EricJ48/ENCE-4231/PhaseB/Notes/solderedboardon.jpg

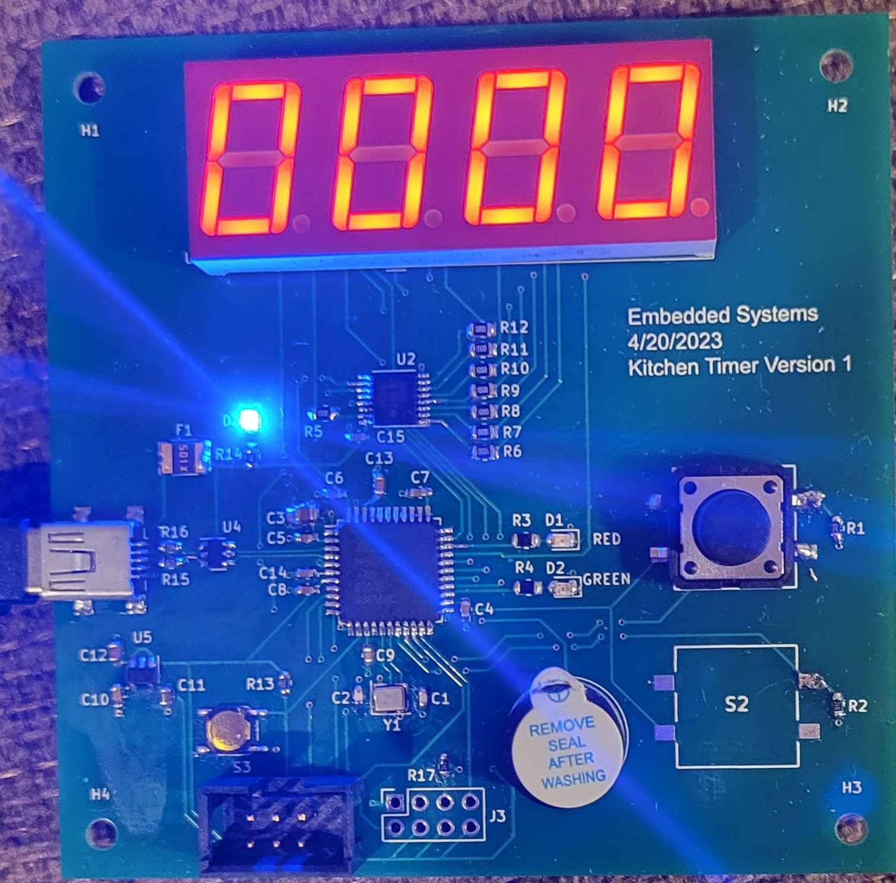
PhaseB/Notes/solderedboardon.jpg
