EricJ48/ENCE-4231/PhaseB/Notes/solderedboard.jpg

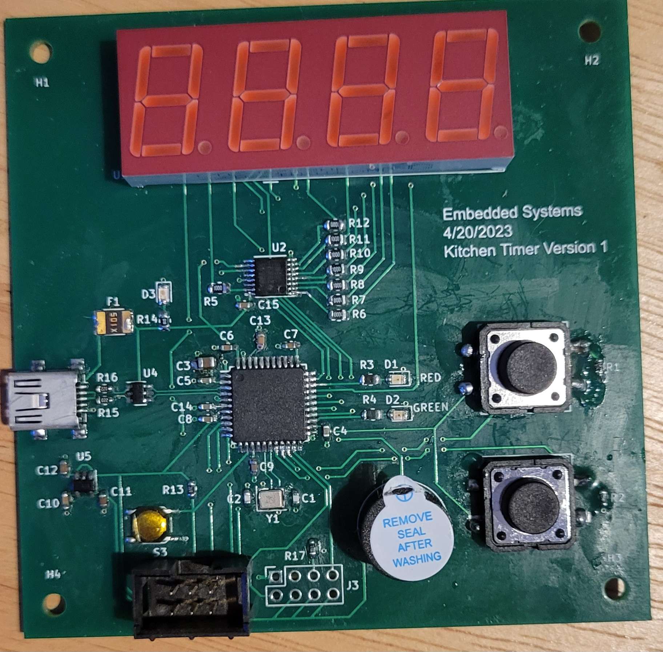
PhaseB/Notes/solderedboard.jpg
