EricJ48/ENCE-4231/PhaseAProofOfConcept.docx

Phase A – Proof of Concept

Kitchen Timer

Project requirements:

- Can be set to up to 100 minutes
- can increment/decrement by 1 second, 10 seconds, 30 seconds, 1 minute, 10 minutes, 30 minutes.
- Plays loud sound when timer runs out
- Needs a display

Components Selection:

- Pushbutton: https://www.amazon.com/6x6x6mm-Momentary-Push-Button-Switch/dp/B01GN79QF8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
- 7 segment display
- Buzzer
- LEDs
