EricJ48/ENCE-4231/PhaseB/Notes/SystemBlockDiagrams.pdf

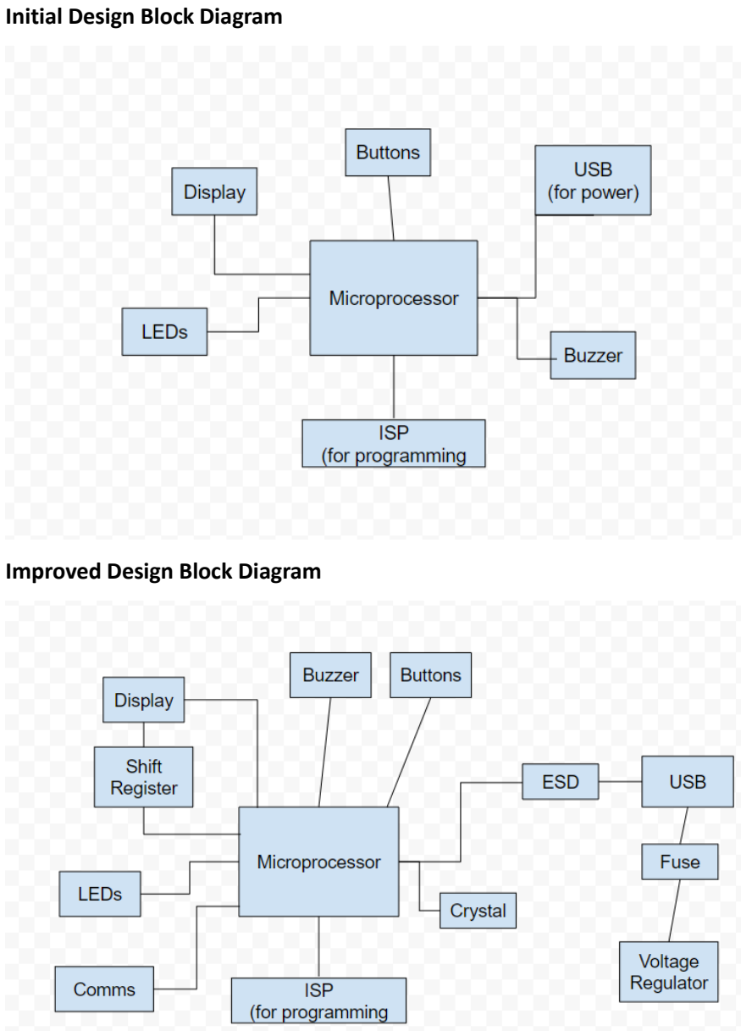
[picture p9: page 1]

Initial Design Block Diagram

Improved Design Block Diagram
