EricJ48/ENCE-4231/PhaseB/PCBDesign/Schematics/Schematic.png

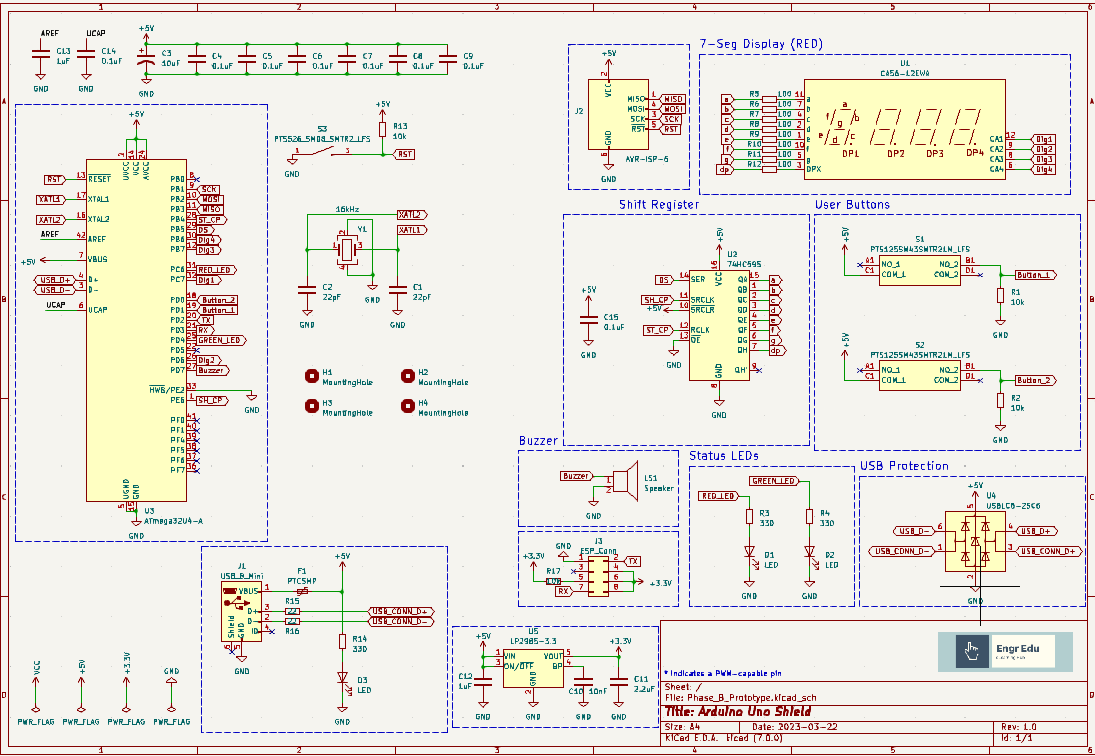
PhaseB/PCBDesign/Schematics/Schematic.png
