EricJ48/ENCE-4231/PhaseD_Nightlight/notes/blockdiagram.png

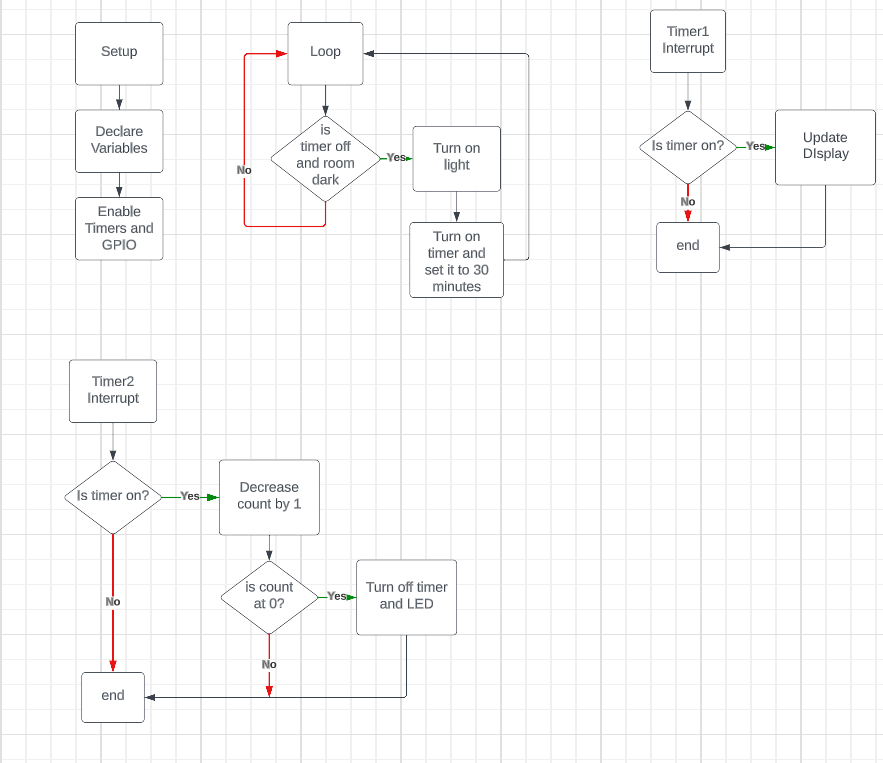
PhaseD_Nightlight/notes/blockdiagram.png
