EricJ48/ENCE-4231/PhaseD_Nightlight/PCBDesign/plots/3D_Model_front.png

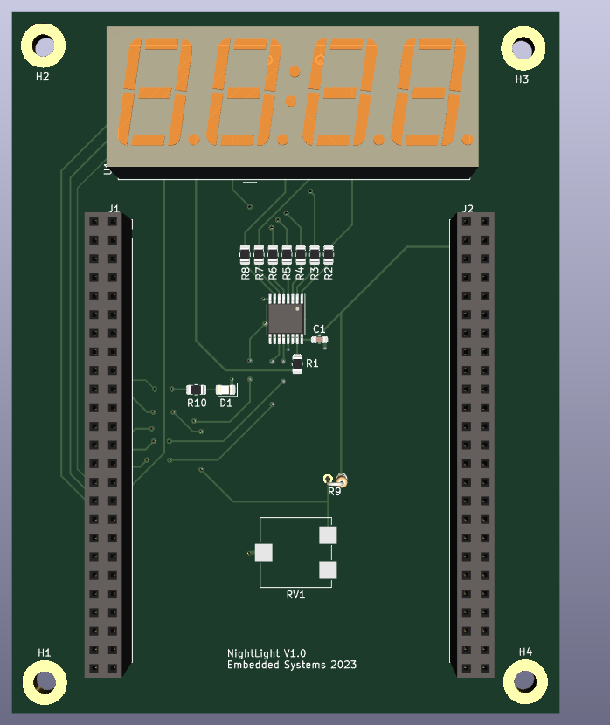
PhaseD_Nightlight/PCBDesign/plots/3D_Model_front.png
