EricJ48/ENCE-4231/PhaseD_Nightlight/PCBDesign/plots/PCB_Layout.png

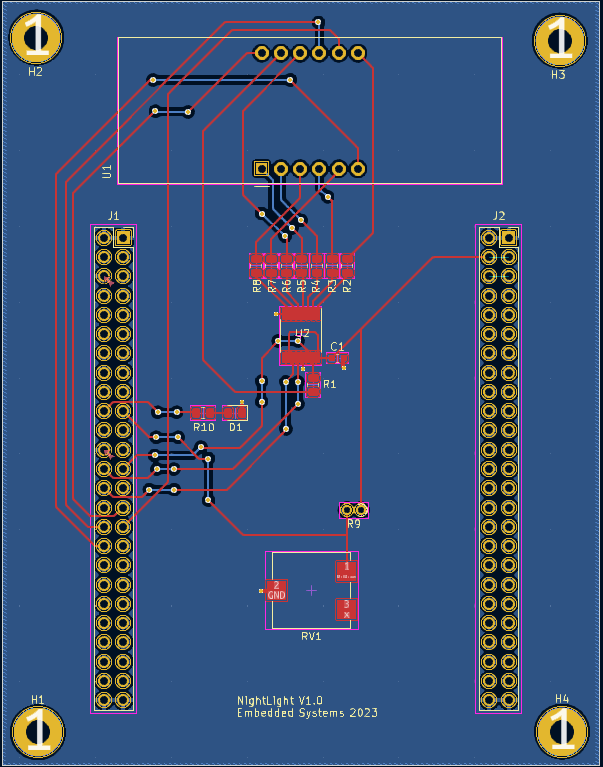
PhaseD_Nightlight/PCBDesign/plots/PCB_Layout.png
