EricJ48/ENCE-4231/PhaseD_Nightlight/PCBDesign/Schematics/Schematic.png

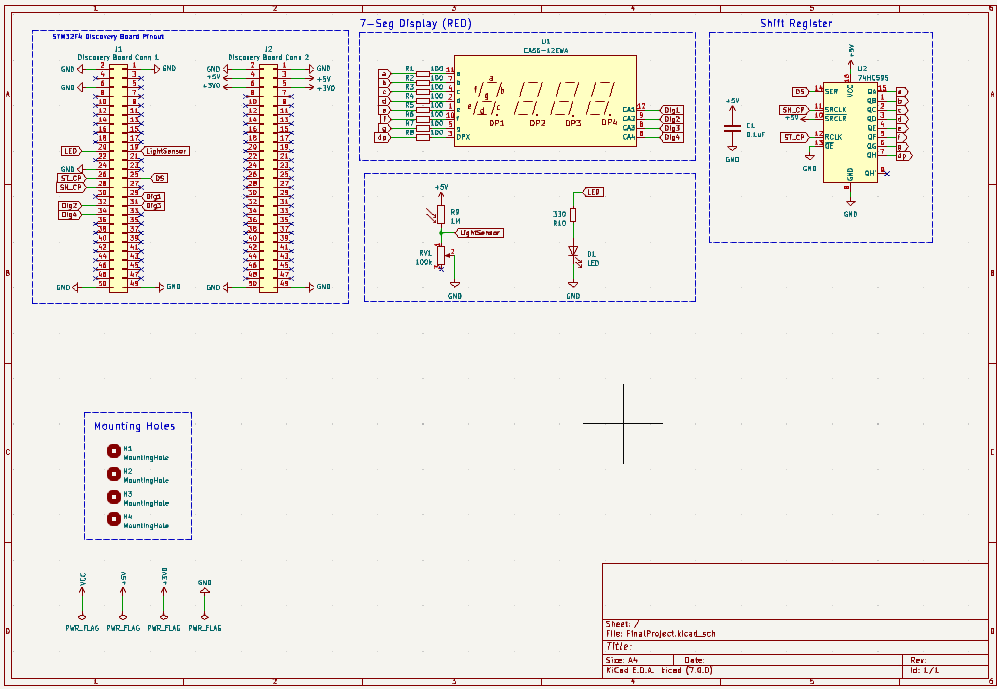
PhaseD_Nightlight/PCBDesign/Schematics/Schematic.png
