EricJ48/ENCE-4231/PhaseB/PCBDesign/Enclosure/TimerEnclosure.STEP

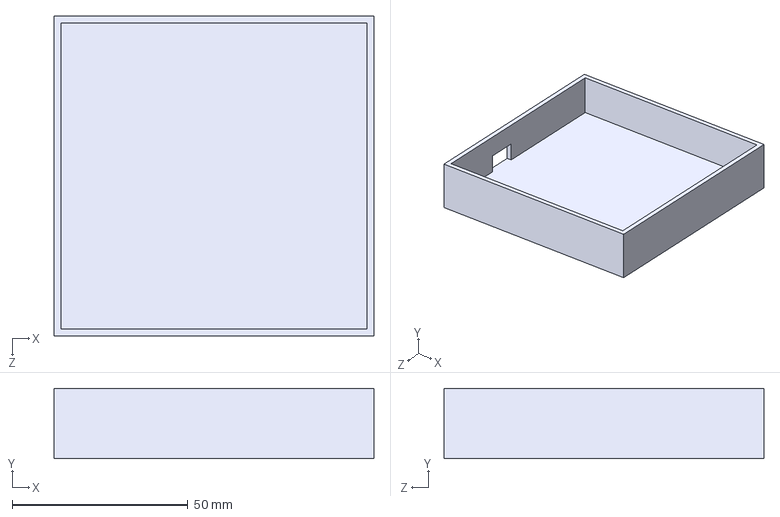
[picture p16: CAD file, 2023-05-04]
PhaseB/PCBDesign/Enclosure/TimerEnclosure.STEP
91.0 x 20.0 x 91.0 mm
