EricJ48/ENCE-4231/Phase_A_UnoShield/plots/PCB_Tutorial_UNOShield__Assembly.pdf

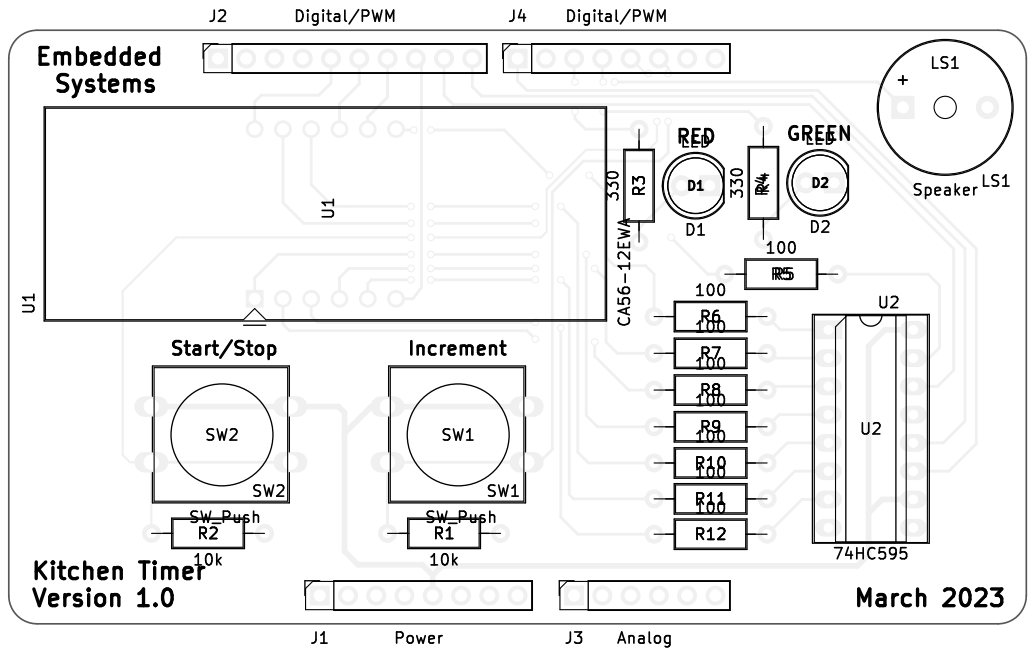
[picture p17: page 1]

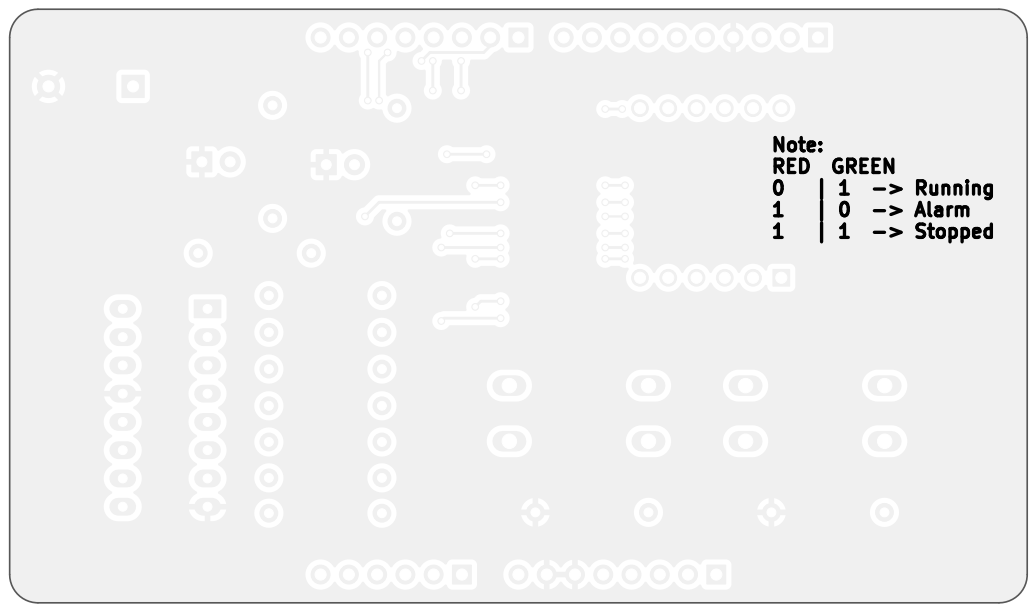
[picture p18: page 2]
D Date: 2023-03-22 KiCad; kicad; 7.0.1 Size: A4; Rev:; Id: 1/1 Title: File:; PCB_Tutorial_UNOShield.kicad_pcb Sheet:
