EricJ48/ENCE-4231/PhaseD_Nightlight/PCBDesign/plots/NightLight_Prototype_Assembly.pdf

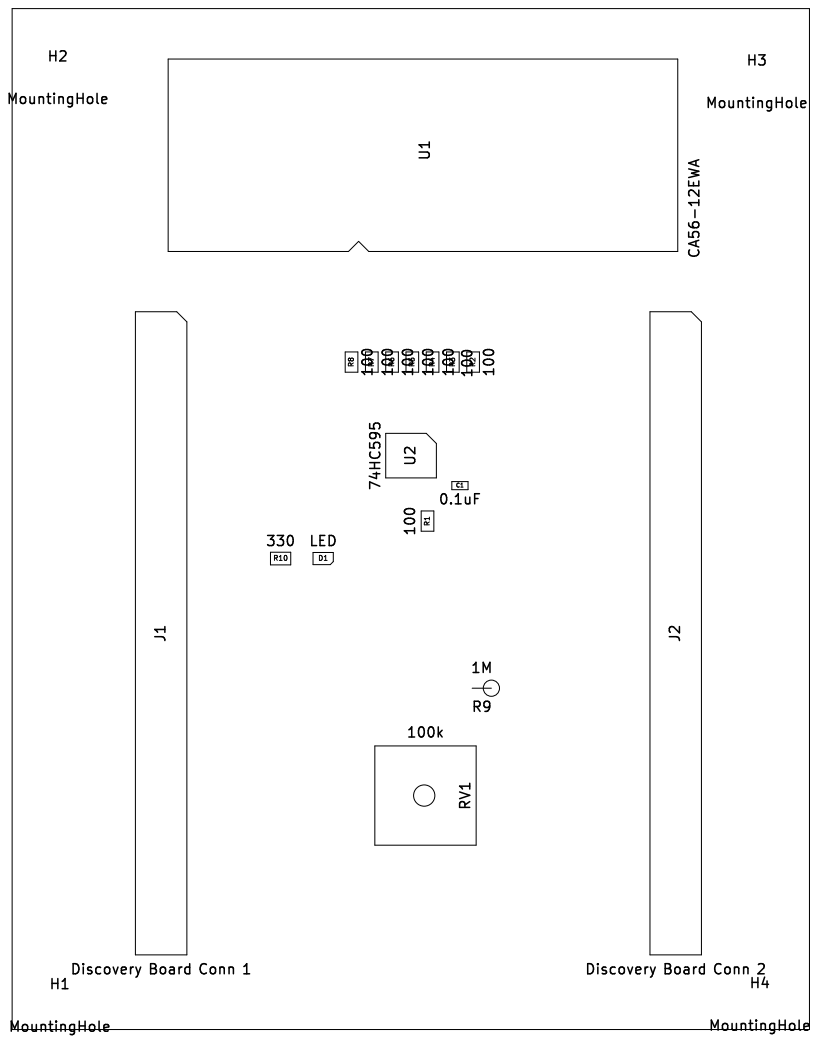
[picture p19: page 1]

Id: 1/1 Title: File: FinalProject.kicad_pcb Sheet:
