EricJ48/ENCE-4231/PhaseB/PCBDesign/Schematics/Phase_B_Prototype.pdf

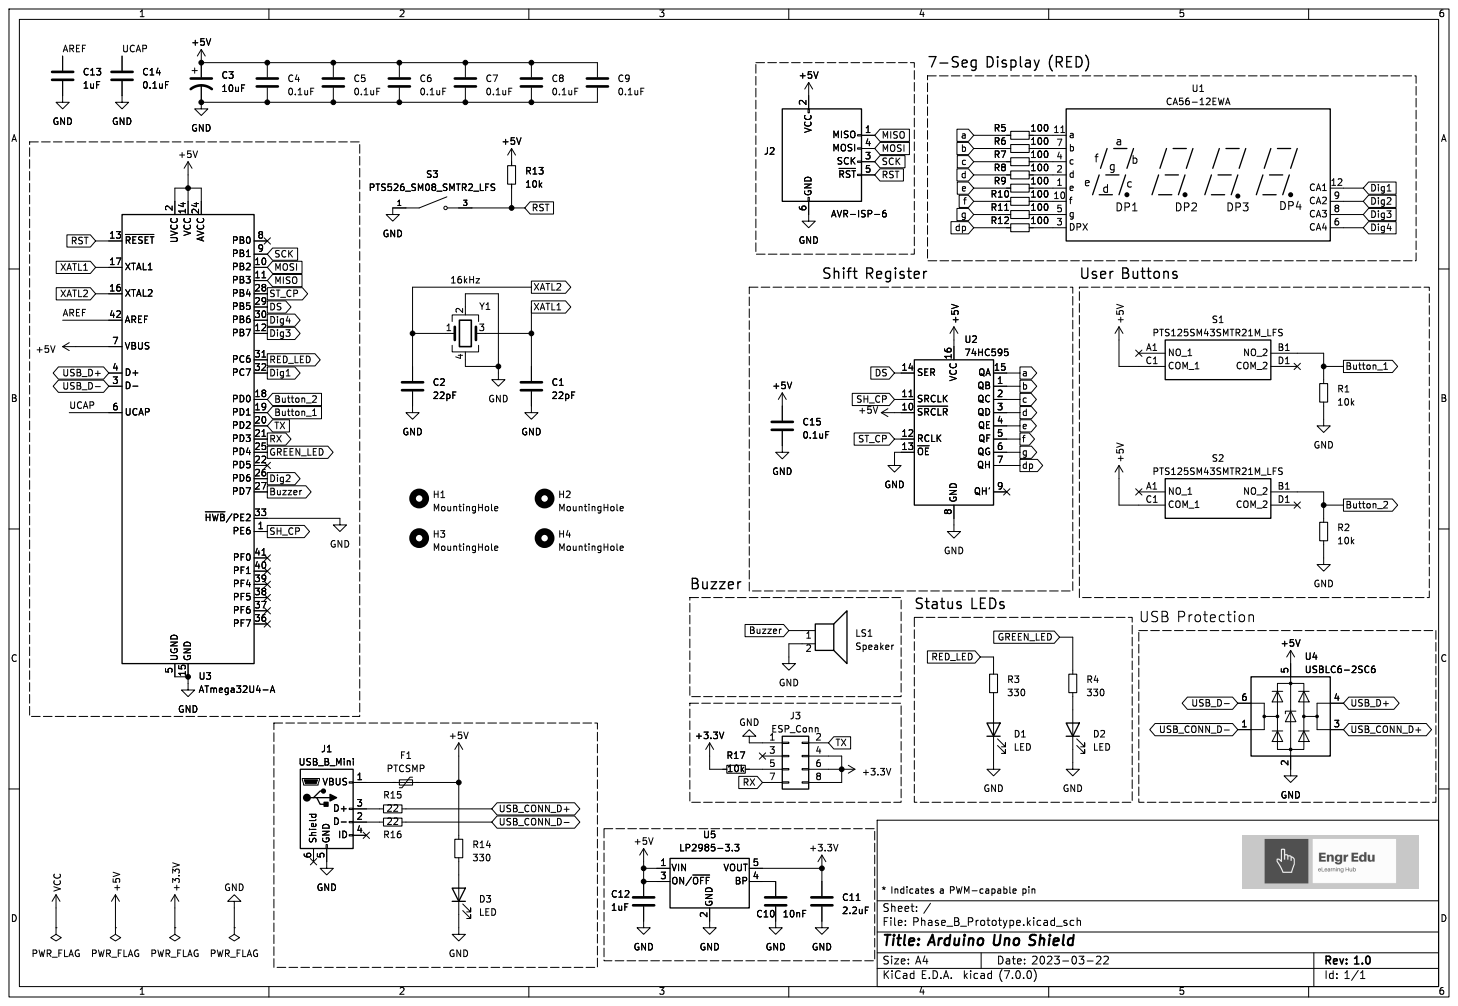
[picture p20: page 1]

2 SCK 3 MOSI 4 ~{RST}5 GND

2 ON/~{OFF} 3 BP 4 VOUT 5 U5

2 ON/~{OFF} 3 BP 4 VOUT 5 C12

File: Phase_B_Prototype.kicad_sch Sheet: /
Id: 1/1 Title: Arduino Uno Shield
