EricJ48/ENCE-4231/PhaseB/Notes/Code Block Diagram.pdf

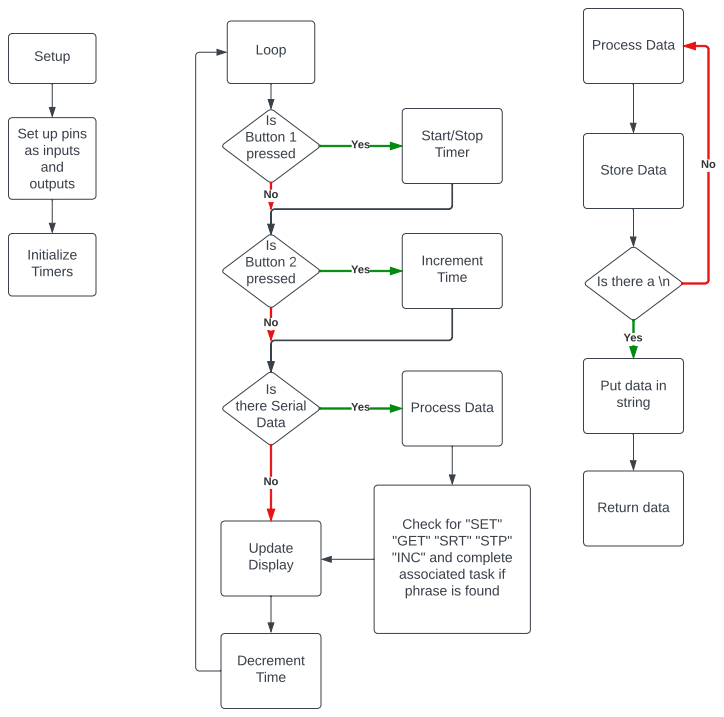
[picture p21: page 1]
Loop; Is Button 1 pressed; Yes; Start/Stop; Timer; Is Button 2 pressed; Increment Time; Is there Serial Data; Process Data; Store Data; Is there a \n; Update Display; Decrement Time; Setup; Initialize Timers; Return data

Set up pins
as inputs
and
outputs

Put data in
string

Check for "SET"
"GET" "SRT" "STP"
"INC" and complete
associated task if
phrase is found
