EricJ48/ENCE-4231/PhaseD_Nightlight/PCBDesign/Schematics/Schematic.pdf

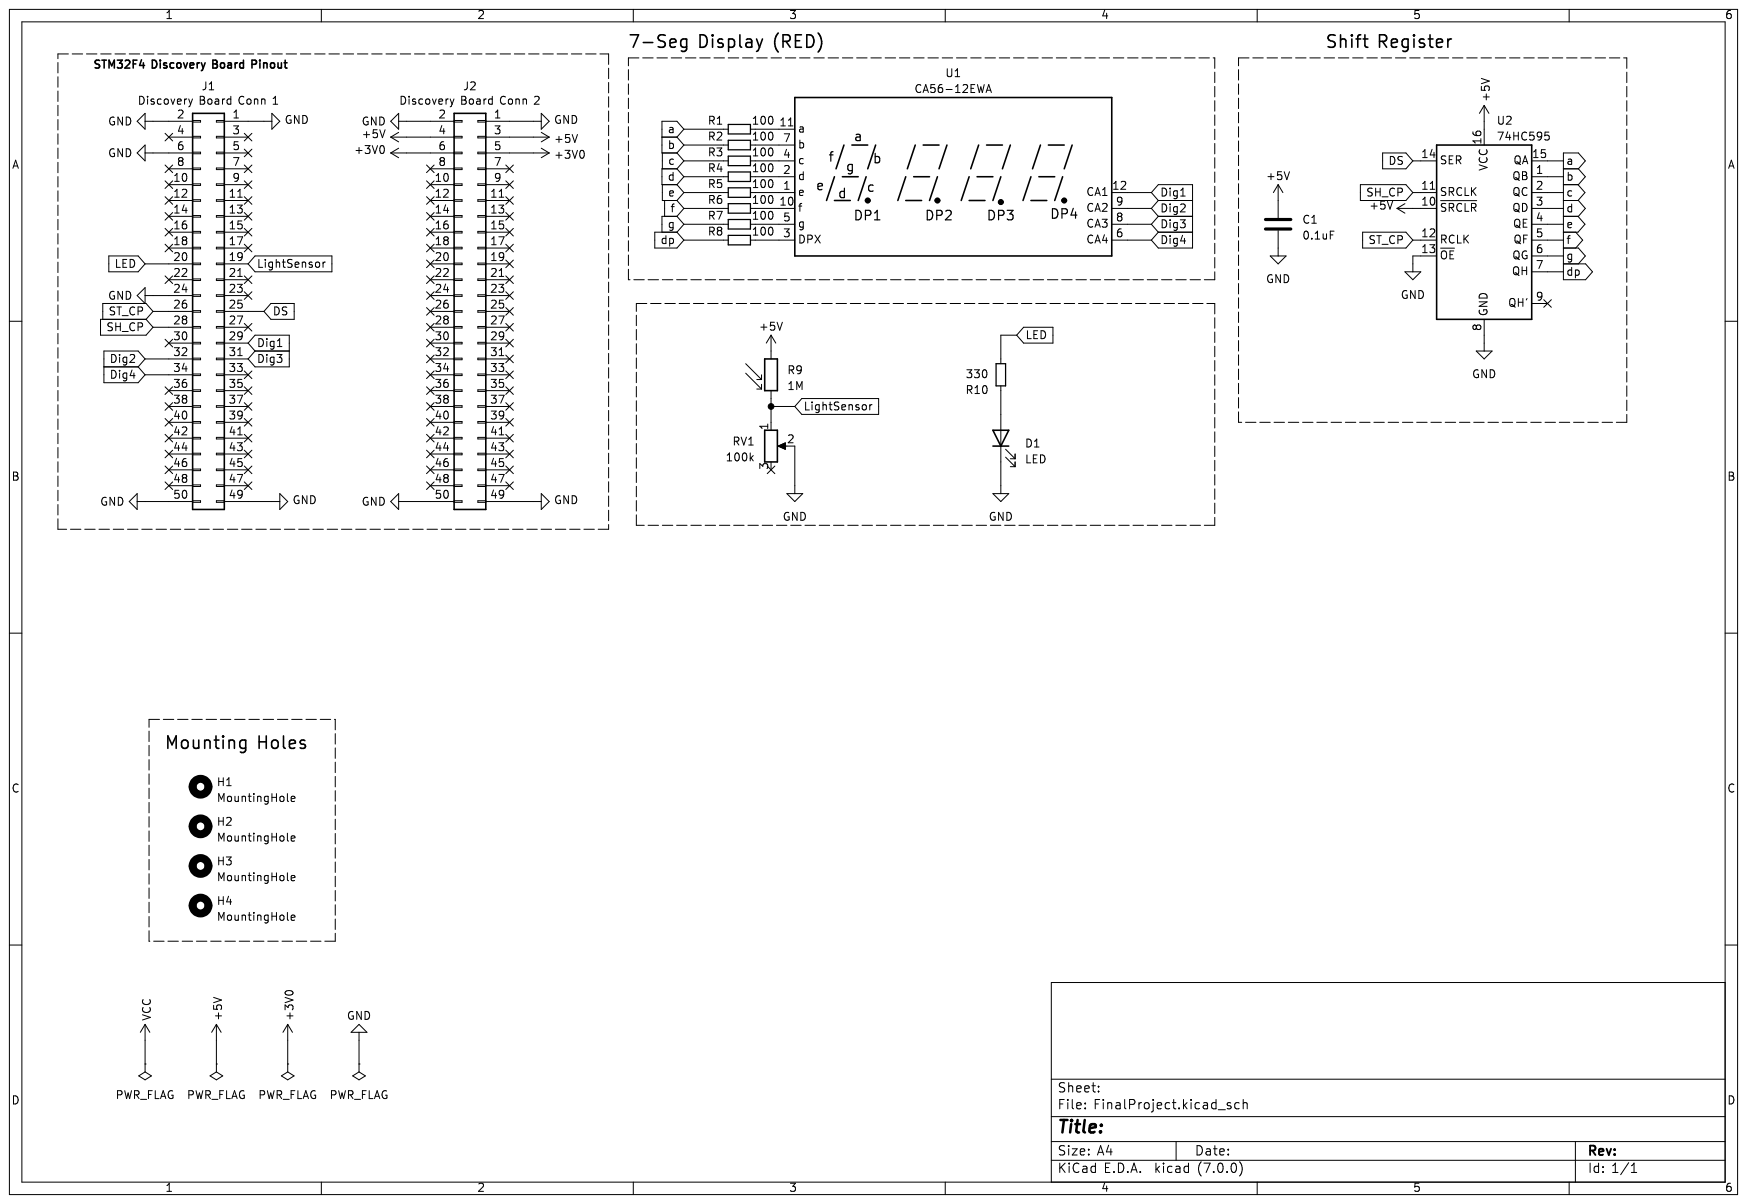
[picture p22: page 1]
