EricJ48/ENCE-4231/PhaseB/PCBDesign/plots/Phase_B_Prototype_Assembly.pdf

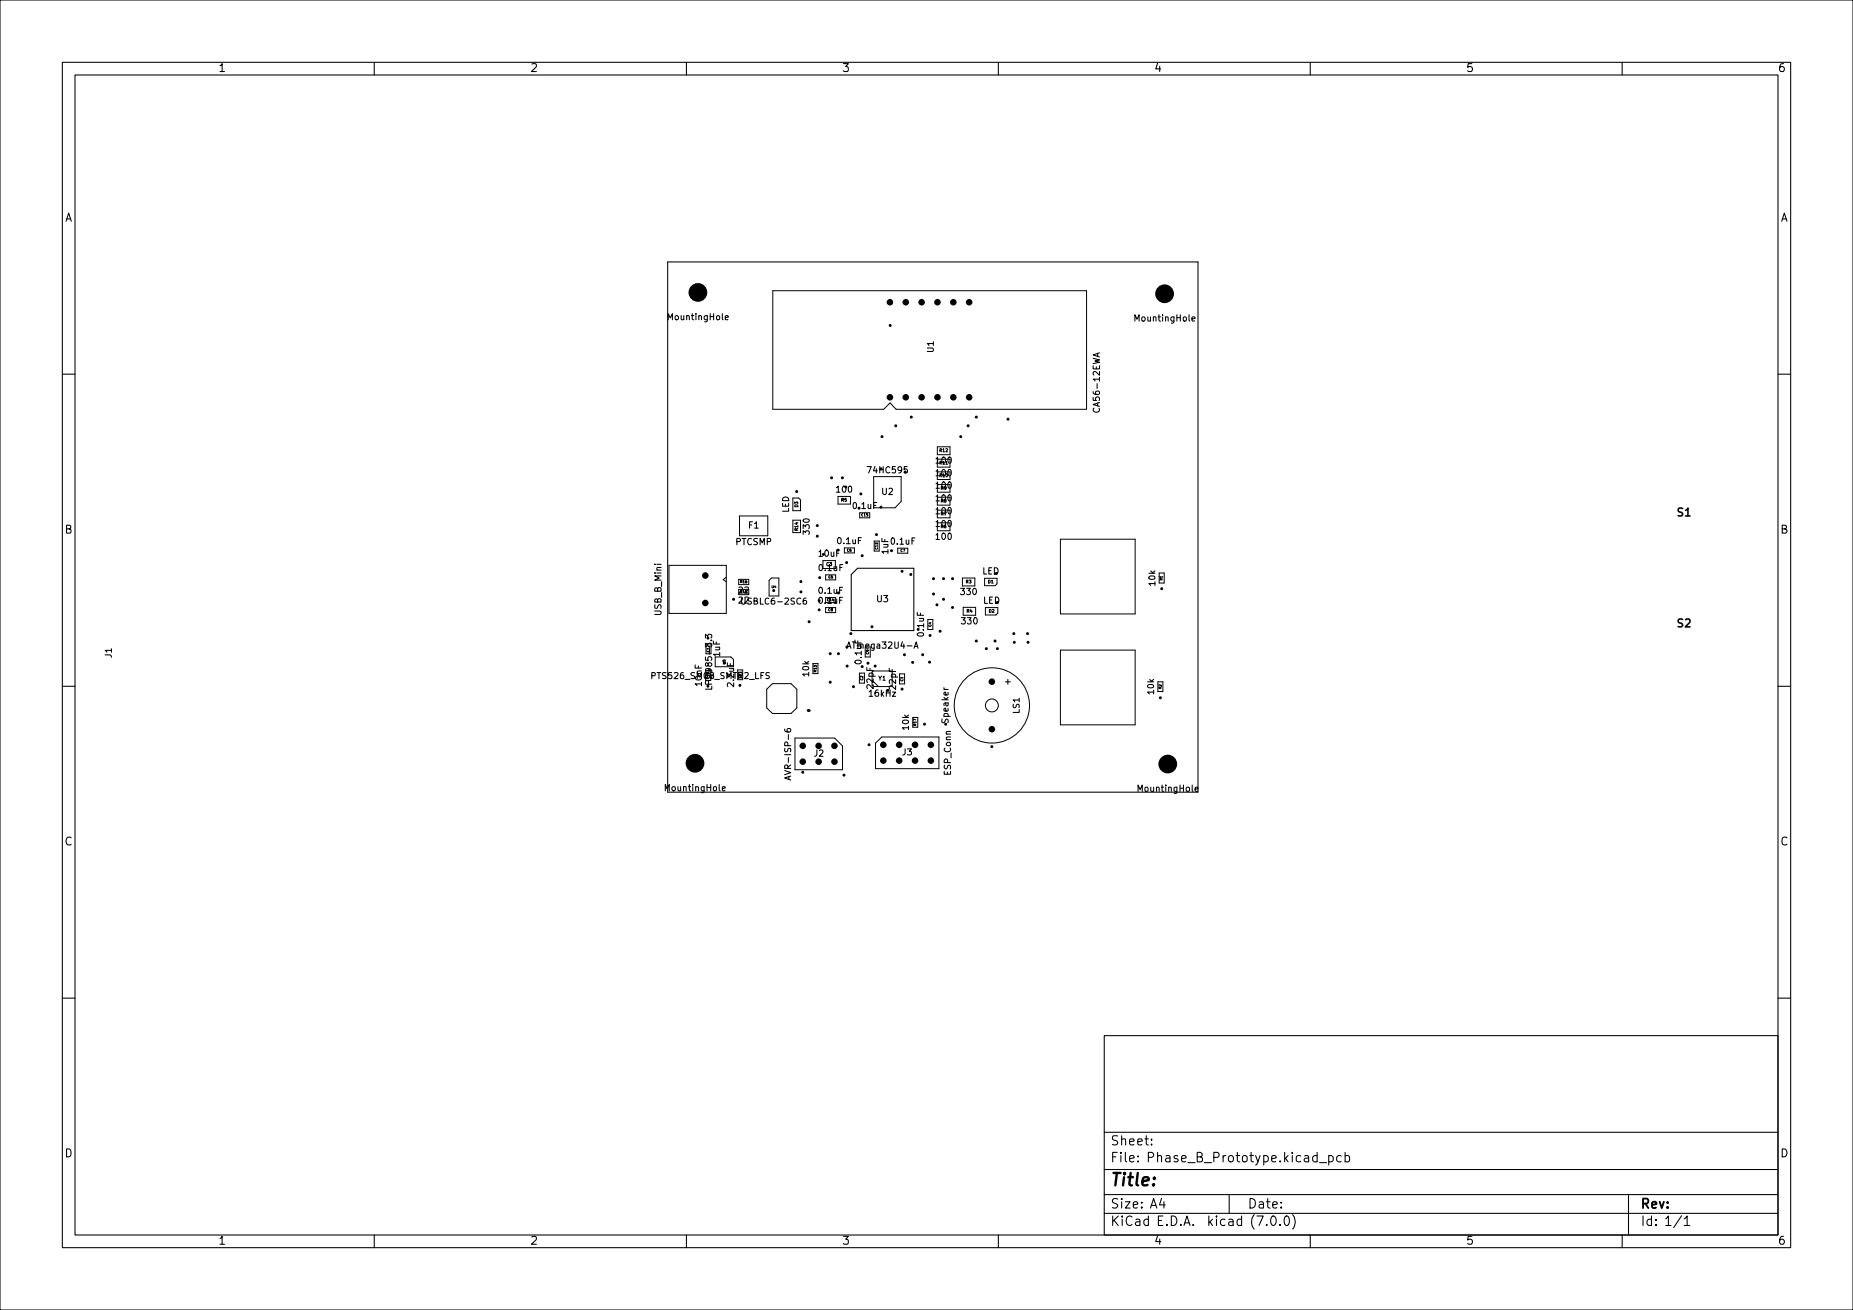
[picture p23: page 1]

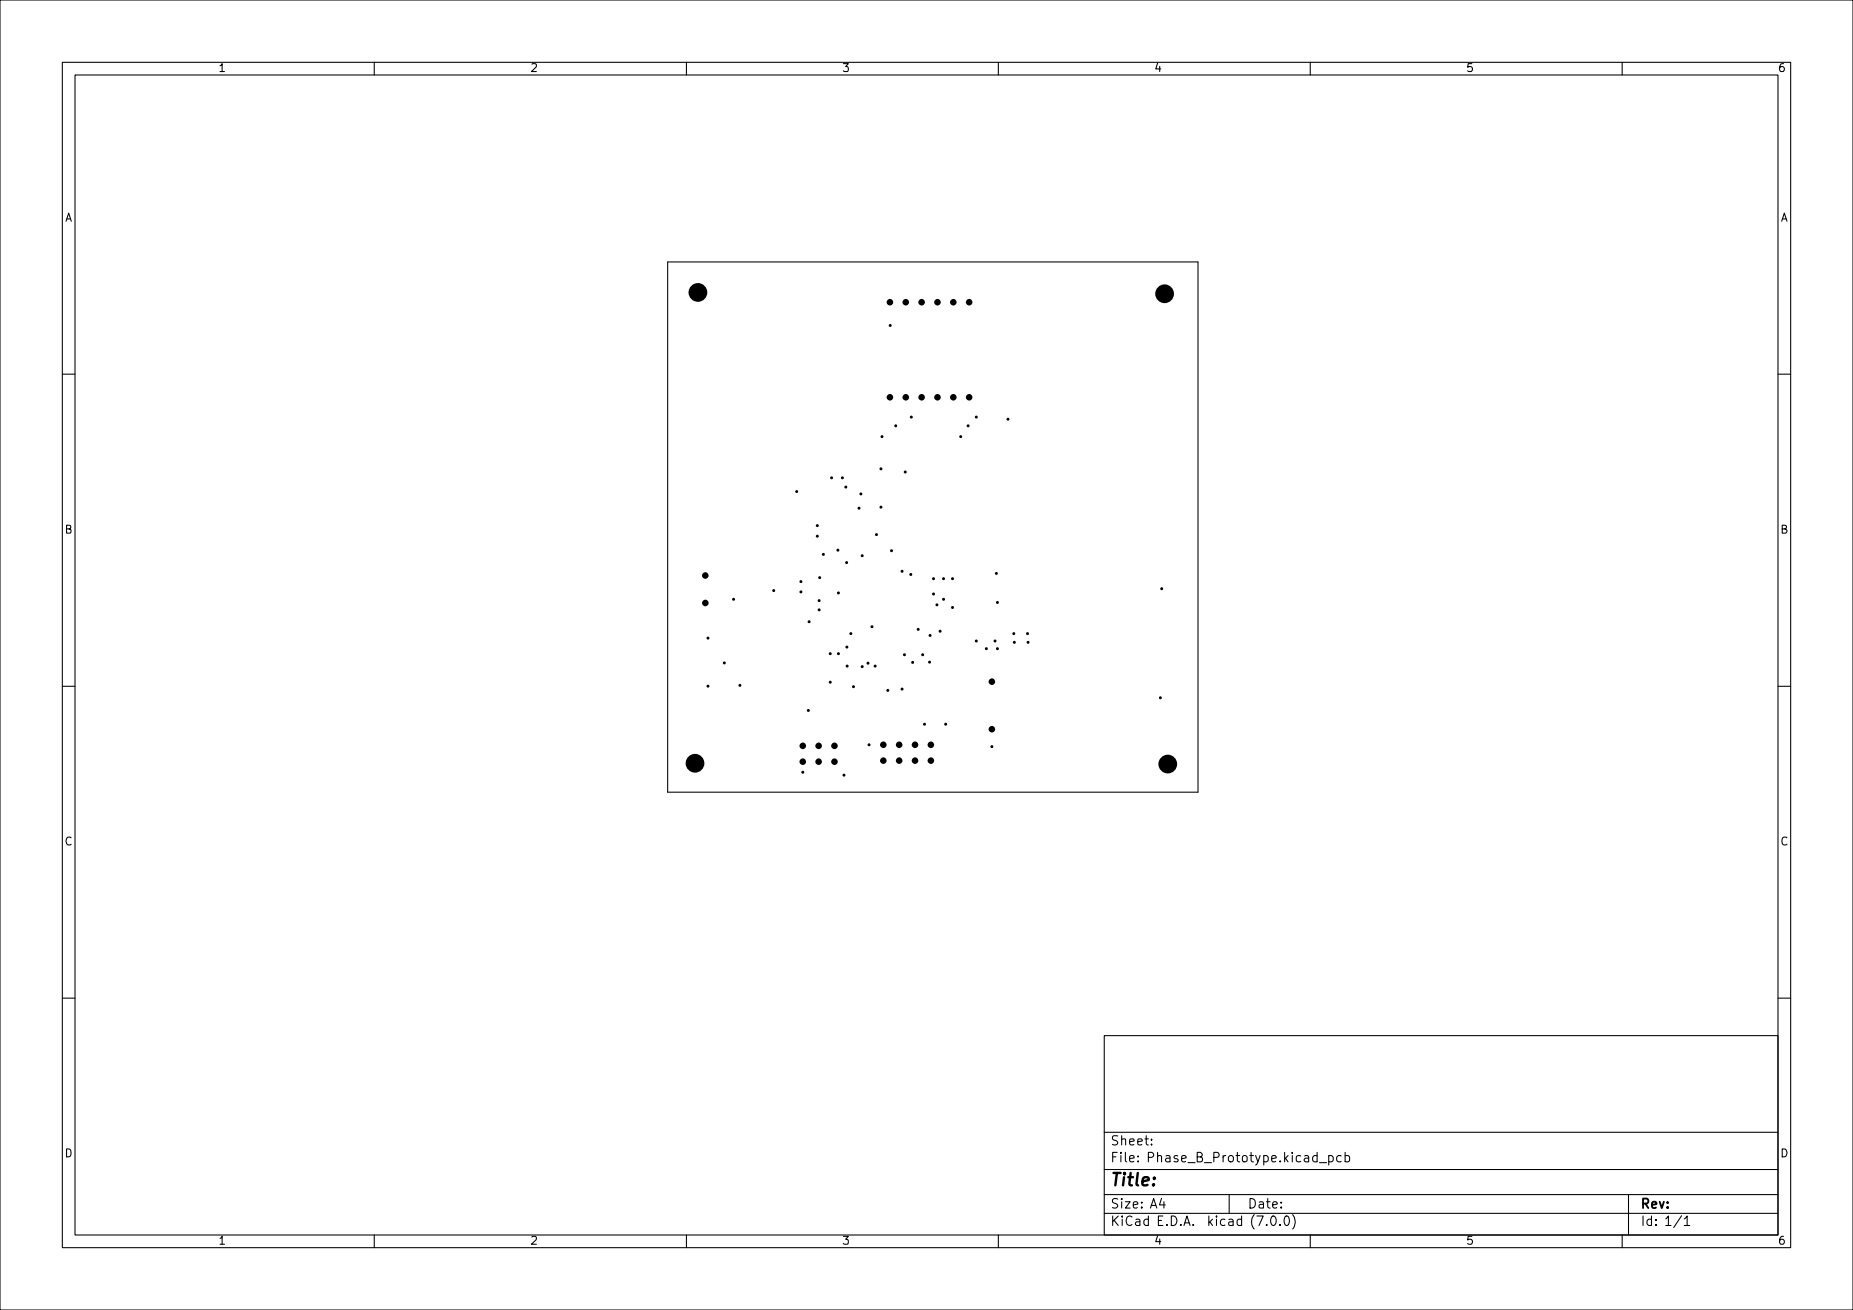
[picture p24: page 2]
