EricJ48/ENCE-4231/PhaseD_Nightlight/PCBDesign/FinalProject.kicad_pcb

## KiCad design PhaseD_Nightlight/PCBDesign/FinalProject.kicad_pcb (2023-06-01)

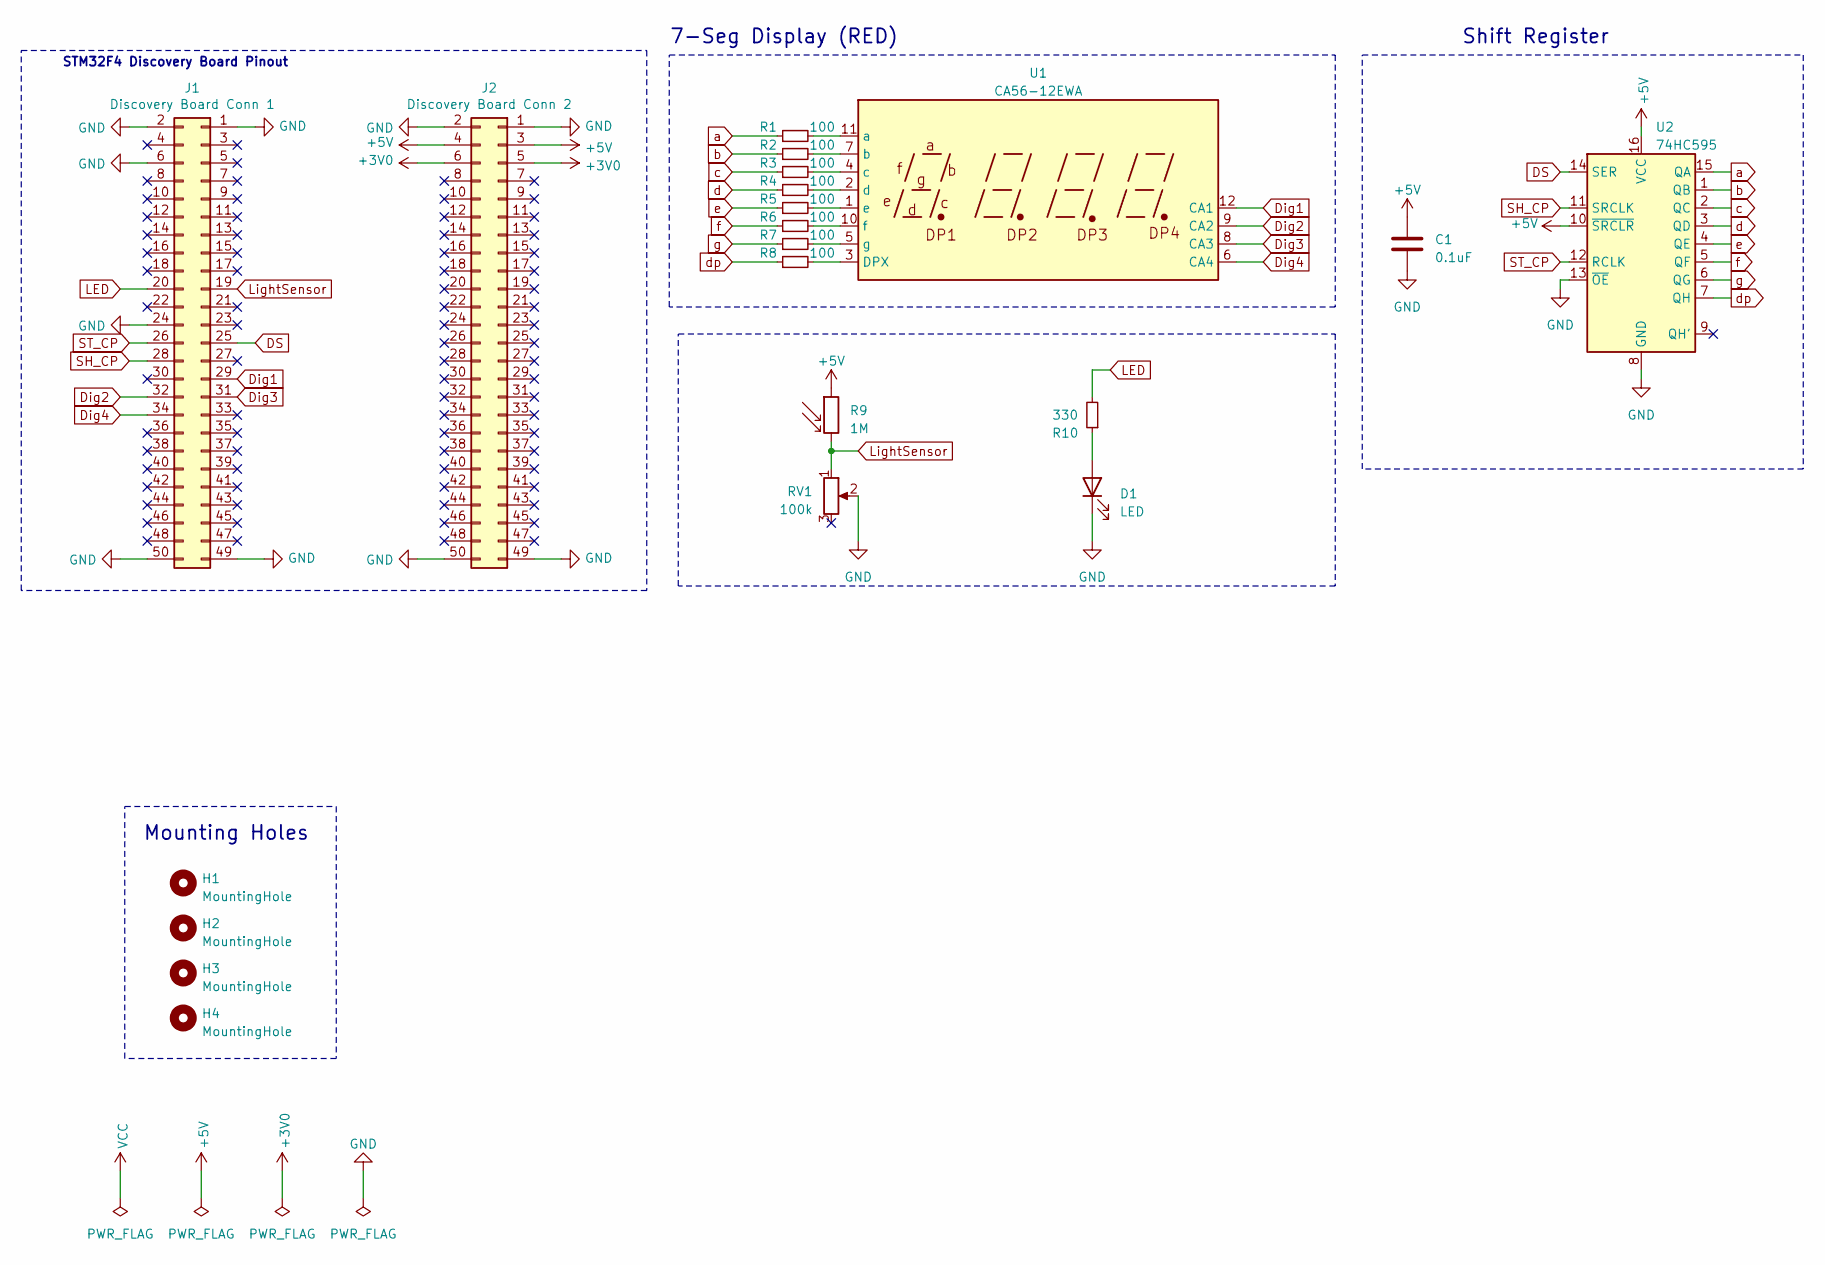
[picture p25: schematic FinalProject.kicad_sch]

Parts:
C1: 0.1uF; C_0603_1608Metric
D1: LED; LED_0805_2012Metric
H1, H2, H3, H4: MountingHole; MountingHole_3.2mm_M3_Pad
J1: Discovery Board Conn 1; PinSocket_2x25_P2.54mm_Vertical
J2: Discovery Board Conn 2; PinSocket_2x25_P2.54mm_Vertical
R1, R2, R3, R4, R5, R6, R7, R8: 100; R_0805_2012Metric
R9: 1M; R_Axial_DIN0204_L3.6mm_D1.6mm_P1.90mm_Vertical
R10: 330; R_0805_2012Metric
RV1: 100k; Potentiometer_ACP_CA9-VSMD_Vertical
U1: CA56-12EWA
U2: 74HC595; TSSOP-16_4.4x5mm_P0.65mm

Connections:
+3V0: J2.5, J2.6
+5V: C1.1, J2.3, J2.4, R9.1, U2.10 (~SRCLR), U2.16 (VCC)
DS: J1.25, U2.14 (SER)
Dig1: J1.29, U1.12 (CA1)
Dig2: J1.32, U1.9 (CA2)
Dig3: J1.31, U1.8 (CA3)
Dig4: J1.34, U1.6 (CA4)
GND: C1.2, D1.1 (K), J1.1, J1.2, J1.6, J1.24, J1.49, J1.50, J2.1, J2.2, J2.49, J2.50, RV1.2, U2.8 (GND), U2.13 (~OE)
LED: J1.20, R10.2
LightSensor: J1.19, R9.2, RV1.1
unnamed: D1.2 (A), R10.1
unnamed: R8.2, U1.3 (DPX)
unnamed: R1.2, U1.11 (a)
unnamed: R2.2, U1.7 (b)
unnamed: R3.2, U1.4 (c)
unnamed: R4.2, U1.2 (d)
unnamed: R5.2, U1.1 (e)
unnamed: R6.2, U1.10 (f)
unnamed: R7.2, U1.5 (g)
SH_CP: J1.28, U2.11 (SRCLK)
ST_CP: J1.26, U2.12 (RCLK)
a: R1.1, U2.15 (QA)
b: R2.1, U2.1 (QB)
c: R3.1, U2.2 (QC)
d: R4.1, U2.3 (QD)
dp: R8.1, U2.7 (QH)
e: R5.1, U2.4 (QE)
f: R6.1, U2.5 (QF)
g: R7.1, U2.6 (QG)

Notes on the sheet:
Mounting Holes
STM32F4 Discovery Board Pinout
7-Seg Display (RED)
Shift Register

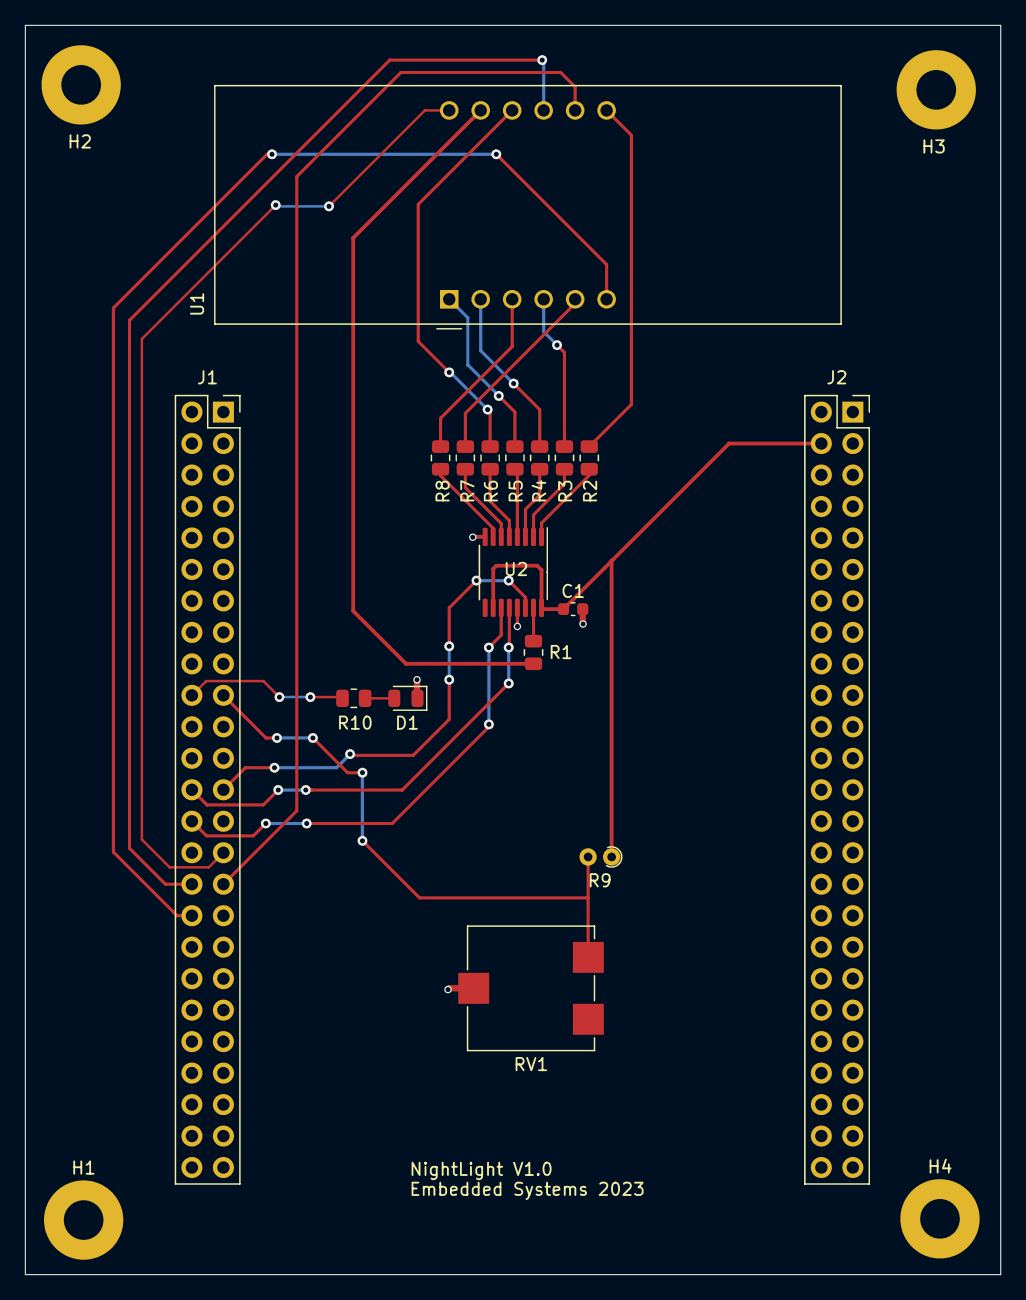
[picture p26: board FinalProject.kicad_pcb from above]

Board: 2 copper layers, 78.7 x 100.8 mm, 21 parts (0 on the bottom side), 29 nets.
